dunkelstern/NightClock/Fabrication/Case/Knob.stl

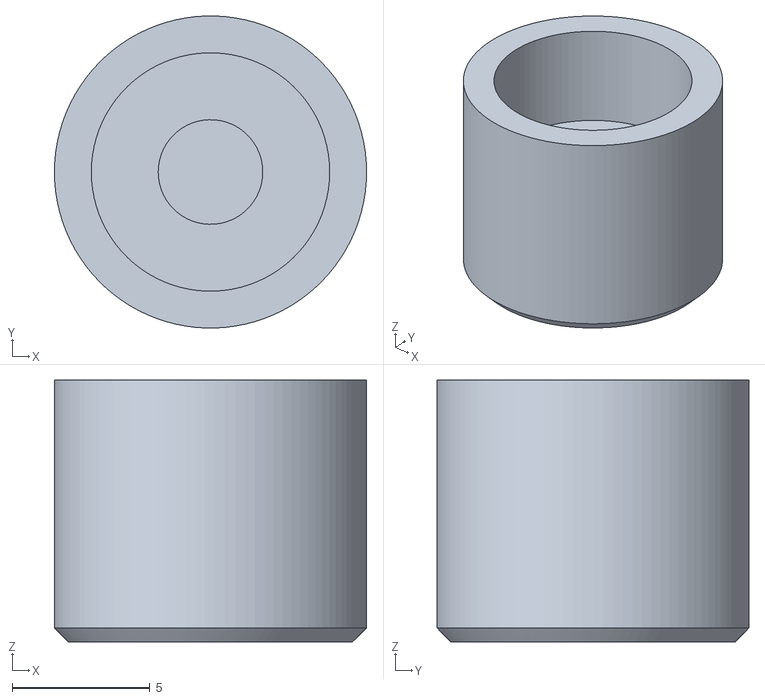
[picture p1: CAD file, 2019-09-05]
Fabrication/Case/Knob.stl
11.3 x 11.3 x 9.50
