dunkelstern/NightClock/Fabrication/Case/Top.stl

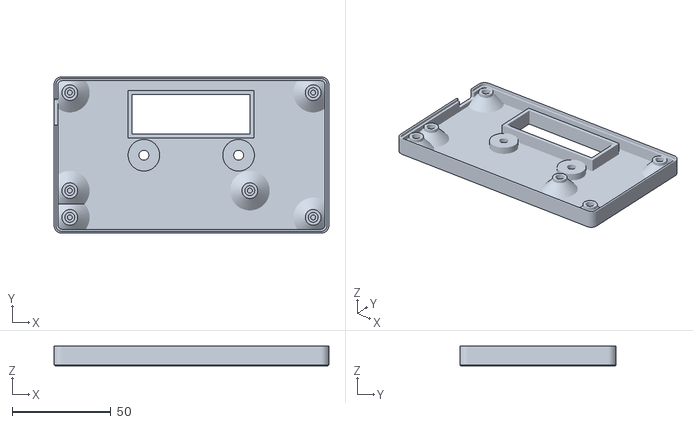
[picture p2: CAD file, 2019-09-05]
Fabrication/Case/Top.stl
139.0 x 79.1 x 10.0
