dunkelstern/NightClock/Fabrication/Case/Bottom.stl

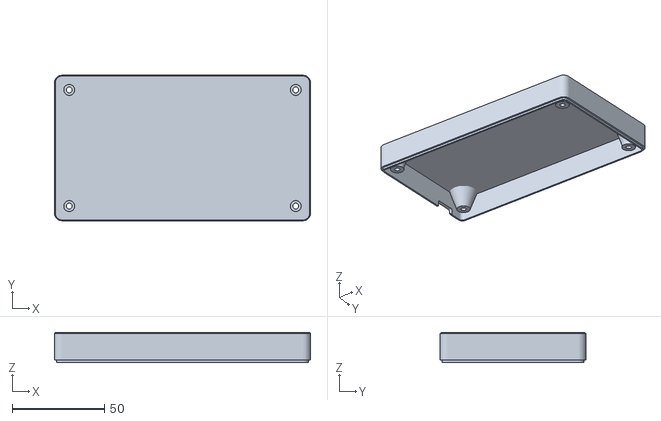
[picture p3: CAD file, 2019-09-05]
Fabrication/Case/Bottom.stl
139.0 x 79.1 x 16.3
