dunkelstern/NightClock/(list of files, cad)

Other CAD files:
Case/Case.f3z
