dunkelstern/NightClock/Fabrication/PCB/Clock-F_Cu.pdf

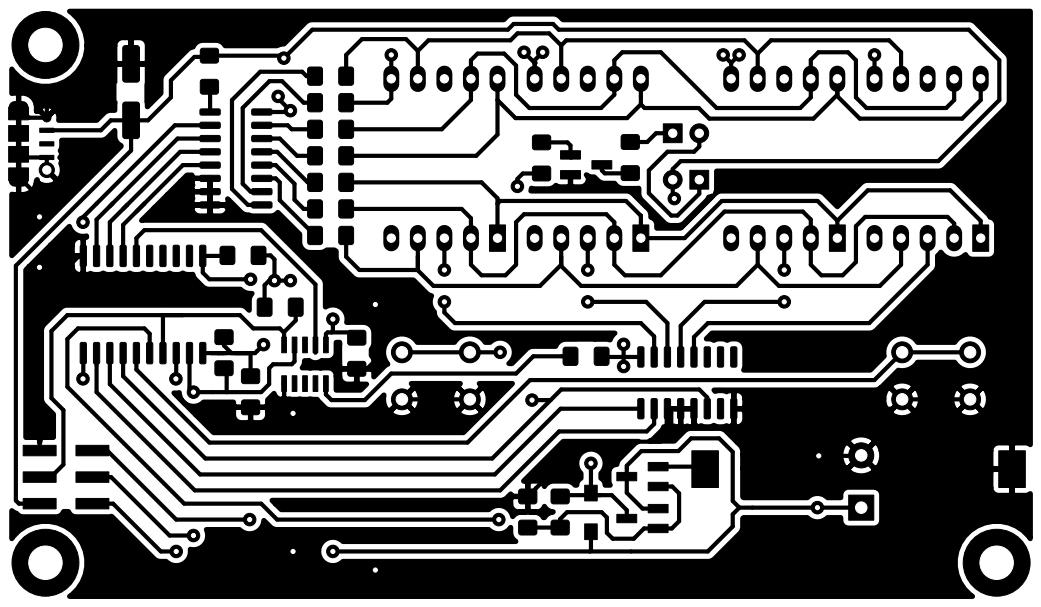
[picture p4: page 1]
