dunkelstern/NightClock/Kicad/Clock.kicad_pcb

## KiCad design Kicad/Clock.kicad_pcb (2019-09-05)

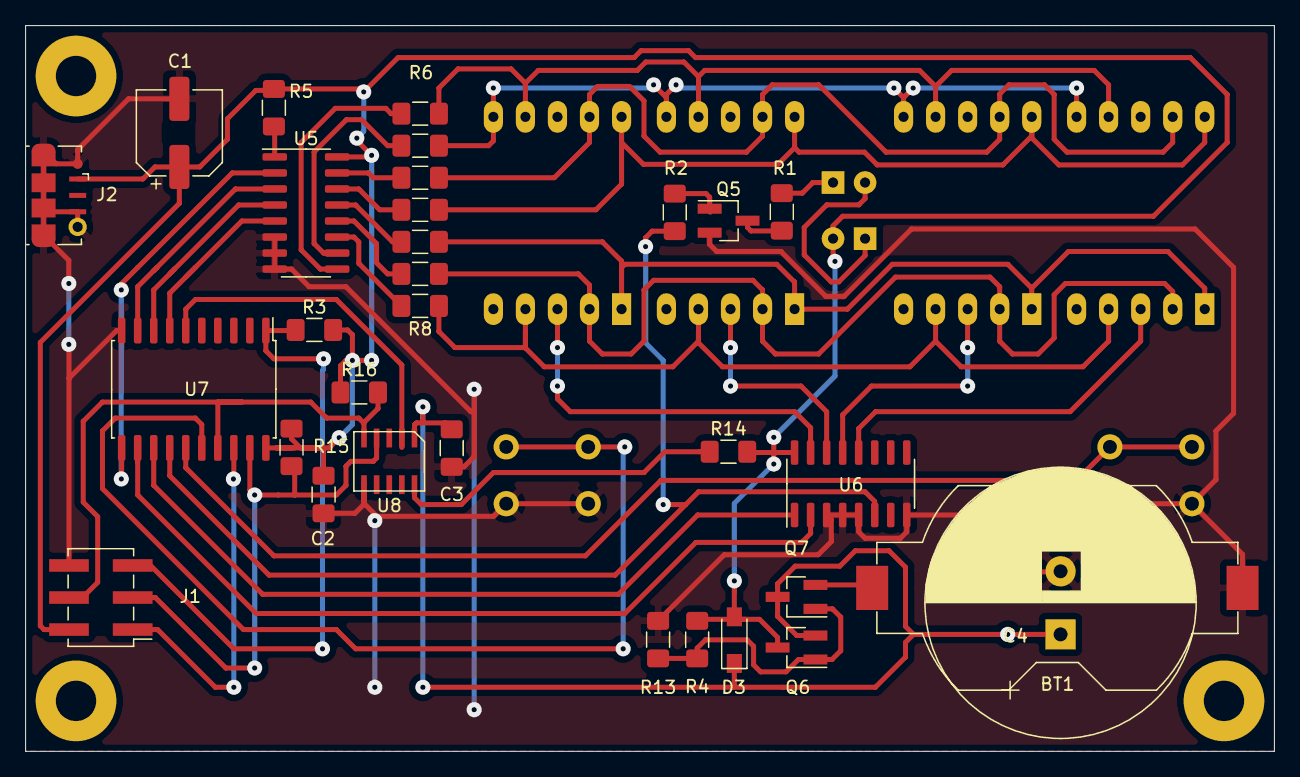
[picture p5: board Clock.kicad_pcb from above]

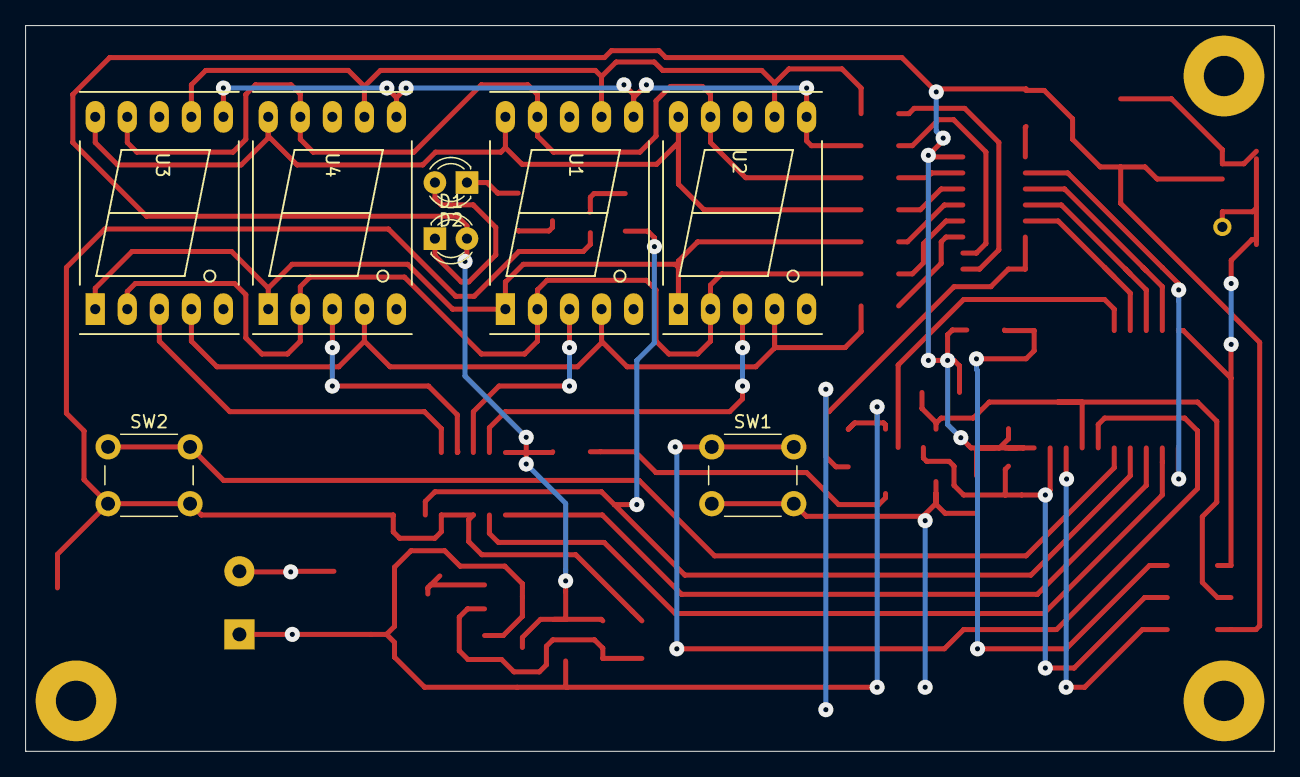
[picture p6: board Clock.kicad_pcb from below]

Board: 2 copper layers, 99.0 x 57.5 mm, 39 parts (8 on the bottom side), 43 nets.

Parts:
BT1: Battery_Cell; BatteryHolder_Keystone_1058_1x2032
C1: 4.7uF; CP_Elec_6.3x5.7
C2, C3: 100nF; C_1206_3216Metric_Pad1.42x1.75mm_HandSolder
C4: 1F; CP_Radial_D14.0mm_P5.00mm
D1, D2: LED; LED_D3.0mm
D3: D; D_SOD-123
J1: AVR-ISP-6; PinHeader_2x03_P2.54mm_Vertical_SMD
J2: USB_B_Micro; USB_Micro-B_Molex-105017-0001
Q5: BC848; SOT-23_Handsoldering
Q6: BC848C; SOT-23_Handsoldering
Q7: BC858A; SOT-23_Handsoldering
R1: 120; R_1206_3216Metric_Pad1.42x1.75mm_HandSolder
R2, R4: 1k; R_1206_3216Metric_Pad1.42x1.75mm_HandSolder
R3, R5, R14: 10k; R_1206_3216Metric_Pad1.42x1.75mm_HandSolder
R6, R7, R8, R9, R10, R11: 150; R_1206_3216Metric_Pad1.42x1.75mm_HandSolder
R12: 160; R_1206_3216Metric_Pad1.42x1.75mm_HandSolder
R13: 100k; R_1206_3216Metric_Pad1.42x1.75mm_HandSolder
R15, R16: 4.7k; R_1206_3216Metric_Pad1.42x1.75mm_HandSolder
SW1: Inc; SW_PUSH_6mm_H13mm
SW2: Prgm; SW_PUSH_6mm_H13mm
U1, U2, U3, U4: KCSC02-123; 7SegmentLED_LTS6760_LTS6780
U5: 4543; SOIC-16_3.9x9.9mm_P1.27mm
U6: 74LS138; SOIC-16_3.9x9.9mm_P1.27mm
U7: ATtiny2313-20SU; SOIC-20W_7.5x12.8mm_P1.27mm
U8: RV-8564-C2

Connections:
+5V: C1.1, C2.1, D1.2, D3.2, J1.2, J2.1, Q6.3, R3.2, R4.2, R5.1, R14.2, R15.1, R16.1, U5.16, U6.16, U7.20
/PWM: R2.2, U6.6, U7.14
/a: R6.1, U1.7, U2.7, U3.7, U4.7
/a0: U6.1, U7.13
/a1: U6.2, U7.12
/b: R7.1, U1.6, U2.6, U3.6, U4.6
/c: R8.1, U1.4, U2.4, U3.4, U4.4
/d: R9.1, U1.2, U2.2, U3.2, U4.2
/d0: U5.5, U7.7
/d1: U5.3, U7.9
/d2: U5.2, U7.11
/d3: U5.4, U7.8
/e: R10.1, U1.1, U2.1, U3.1, U4.1
/f: R11.1, U1.9, U2.9, U3.9, U4.9
/g: R12.1, U1.10, U2.10, U3.10, U4.10
/l0: U3.3, U6.12
/l1: U4.3, U6.13
/l2: U1.3, U6.14
/l3: U2.3, U6.15
BAT_BACKUP: C3.1, C4.1, D3.1, Q6.2, Q7.3, U8.1
GND: BT1.2, C1.2, C2.2, C3.2, C4.2, J1.6, J2.5, J2.6, Q5.2, R13.2, SW1.2, SW2.2, U5.6, U5.7, U5.8, U6.3, U6.4, U6.5, U6.8, U7.10, U8.6
INC_BTN: SW1.1, U7.16
unnamed: BT1.1, Q7.2
unnamed: D1.1, D2.2
unnamed: D2.1, R1.1
unnamed: J1.1, U7.18
unnamed: J1.3, R15.2, U7.19, U8.4
unnamed: J1.4, R16.2, U7.17, U8.5
unnamed: J1.5, R3.1, U7.1
unnamed: Q5.1, R2.1
unnamed: Q5.3, R1.2
unnamed: Q6.1, Q7.1, R4.1, R13.1
unnamed: R5.2, U5.1
unnamed: R6.2, U5.9
unnamed: R7.2, U5.10
unnamed: R8.2, U5.11
unnamed: R9.2, U5.12
unnamed: R10.2, U5.13
unnamed: R11.2, U5.15
unnamed: R12.2, U5.14
unnamed: R14.1, U8.10
unnamed: U7.6, U8.2
PRGM_BTN: SW2.1, U7.15
