dunkelstern/NightClock/(commit log)

2019-09-04 KiCAD PCB
    [Clock.kicad_pcb, Clock.sch]
2019-09-05 Add Gerbers to fabrication
    [Clock-F_Cu.gbr, Clock.drl]
2019-09-05 Update PCB silkscreen
    [Clock.kicad_pcb]
2019-09-05 Flip Supercap to other board side
    [Clock.kicad_pcb]
2019-09-05 PCB Step file
2019-09-05 Case Fusion360 Archive
    [Case.f3z]
2019-09-05 STL Fabrication Files
    [Bottom.stl, Knob.stl, Top.stl]
